jaseg/OpenStep/Outputs/BOM/Bill of Materials-cyberstairs.xls

Comment | Description | Designator | Footprint | LibRef | Quantity
Cap Pol1 | Polarized Capacitor (Radial) | C1 | RB7.6-15 | Cap Pol1 | 1.0
CAP 10nF 100V 0805(2012) | CAP 10nF 100V ±10% 0805 (2012 Metric) Thickness 1.45mm SMD | C2, C3, C4, C5, C6, C7, C8, C9, C10, C11, C12, C13, C14, C15, C16, C17 | CAPC0805(2012)145_L | CMP-1036-03853-1 | 16.0
SMAJ5.0CA-E3/5A | Transient Voltage Suppressor, 6.40 to 231 V, 5 V Stand-off Voltage, Bi-Directional, -55 to 155 degC, 2-pin DO-214AC, Pb-Free, Tape and Reel | D1 | VISH-DO-214AC-2_N | CMP-0548-00276-2 | 1.0
KP-1608MGC | LED, SMT, 0603(1608), 1.1mm thickness, Green | DS1 | KING-0603LED_GREEN_V | CMP-0404-00001-1 | 1.0
KP-1608SYCK | LED, SMT, 0603(1608), 1.1mm thickness, Yellow | DS2 | KING-0603LED_YELLOW_V | CMP-0404-00003-1 | 1.0
Header 4 | Header, 4-Pin | P1 | HDR1X4 | Header 4 | 1.0
Piezo solder pads | Header, 2-Pin | P2, P3, P4 | SMA_STANDING | Header 2 | 3.0
Phoenix_PT1,5/4-5,0H |  | P5 | Phoenix_PT_1,5/4-5,0-H | Phoenix_PT1,5/4-5,0H | 1.0
Header 3 | Header, 3-Pin | P6 | HDR1X3 | Header 3 | 1.0
IRLML6344TRPbF | N-channel Enhancement Mode Field-Effect Transistor; 5.8A/30V | Q1, Q2, Q3 | AO-SOT23-3_V | CMP-0278-00001-1 | 3.0
470K 1% 0805(2012) | 470K 0.125W 1% 0805 (2012 Metric) SMD | R1, R2, R3, R4, R5, R6, R7, R8, R9, R10, R12, R14, R16 | RESC0805(2012)_N | CMP-1013-00812-1 | 13.0
47K 1% 0805(2012) | 47K 0.125W 1% 0805 (2012 Metric) SMD | R11, R13, R15 | RESC0805(2012)_N | CMP-1013-00812-1 | 3.0
10K 1% 0805(2012) | 470K 0.125W 1% 0805 (2012 Metric) SMD | R17 | RESC0805(2012)_N | CMP-1013-00812-1 | 1.0
AP2202K-3.3TRG1 | 50 mA, 100 mA and 150 mA CMOS LDOs with Active-Low Shutdown and Reference Bypass, 5-Pin SOT-23, Extended Temperature, Tape and Reel | U1 | SOT-23-CT5_L | CMP-0136-00629-1 | 1.0
LM324M | Low Power Quad Operational Amplifier, 14-pin Narrow SOIC | U2 | M14A_M | CMP-0055-00738-2 | 1.0
MSP430G2153IPW20 | 16 MHz Mixed Signal Microcontroller with 1 KB Flash, 256 B SRAM and 24 GPIOs, -40 to 85 degC, 20-pin SOP (PW), Green (RoHS & no Sb/Br) | U3 | TI-PW20_N | CMP-0365-00610-1 | 1.0
ST1480ACDR | Multipoint RS-485/RS-422 Transceiver, 8-pin Narrow SOIC | U4 | M08A_N | CMP-0058-00814-1 | 1.0
7B-25.000MAAE-T | Crystal, SMD, 25.000000MHz Stab=50ppm 18.0pF | Y1 | ABRA-ABM3B-4_V | CMP-0277-00001-1 | 1.0
