jaseg/OpenStep/cyberstairs.PDF

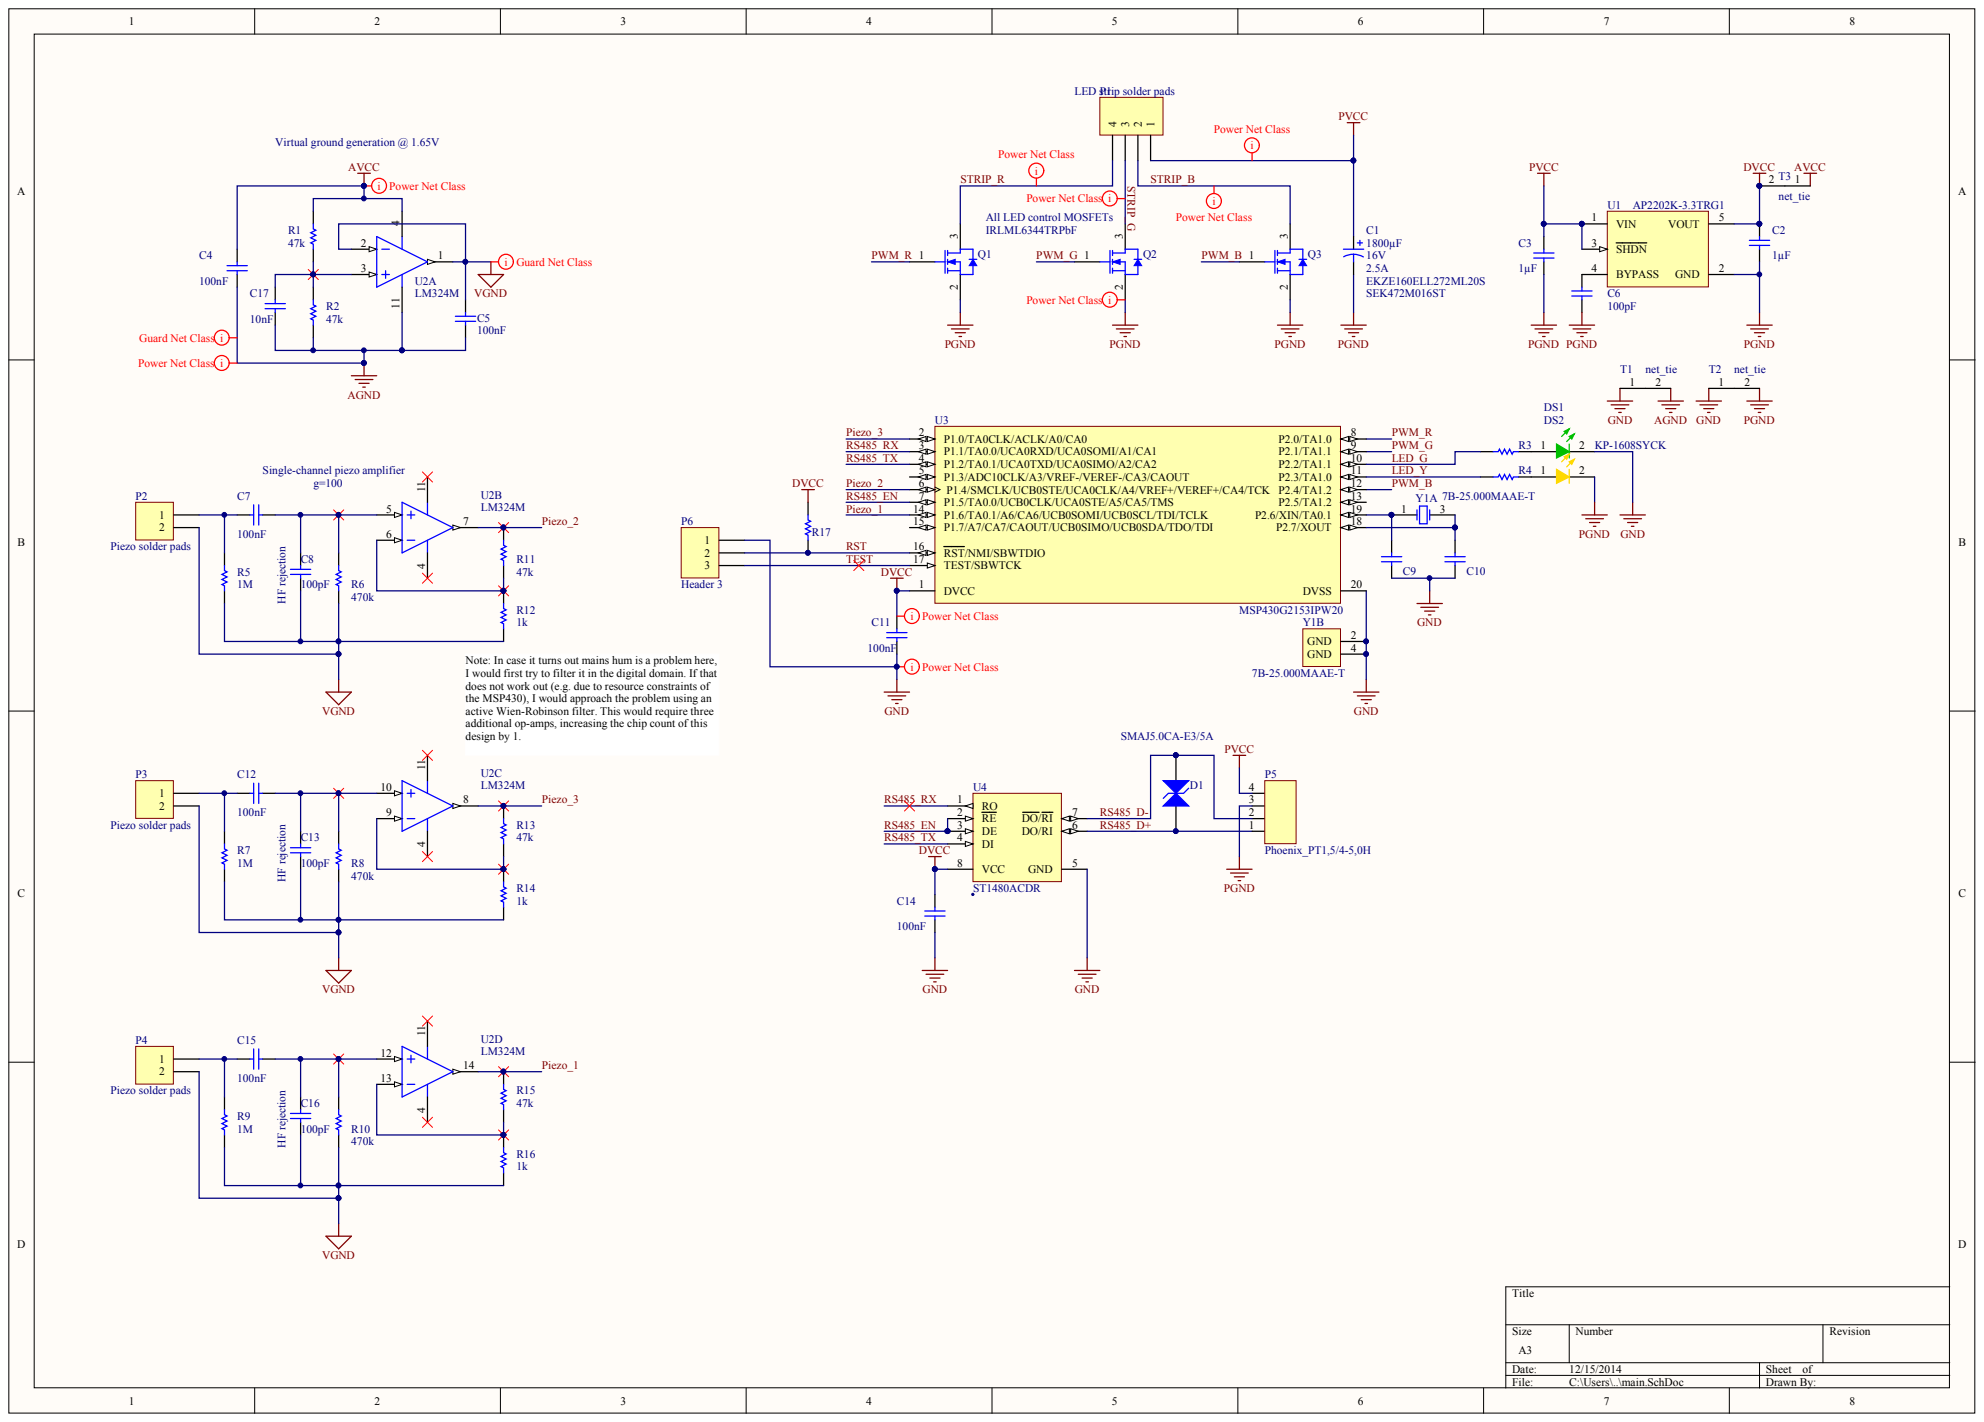
[picture p1: page 1]

LED strip solder pads

All LED control MOSFETs
IRLML6344TRPbF

Single-channel piezo amplifier

RST 1

TEST | | TEST/SBWTCK 17
DVCC C11 100nF | | DVCC 1

Note: In case it turns out mains hum is a problem here,
I would first try to filter it in the digital domain. If that
does not work out (e.g. due to resource constraints of
the MSP430), I would approach the problem using an
active Wien-Robinson filter. This would require three
additional op-amps, increasing the chip count of this
design by 1.

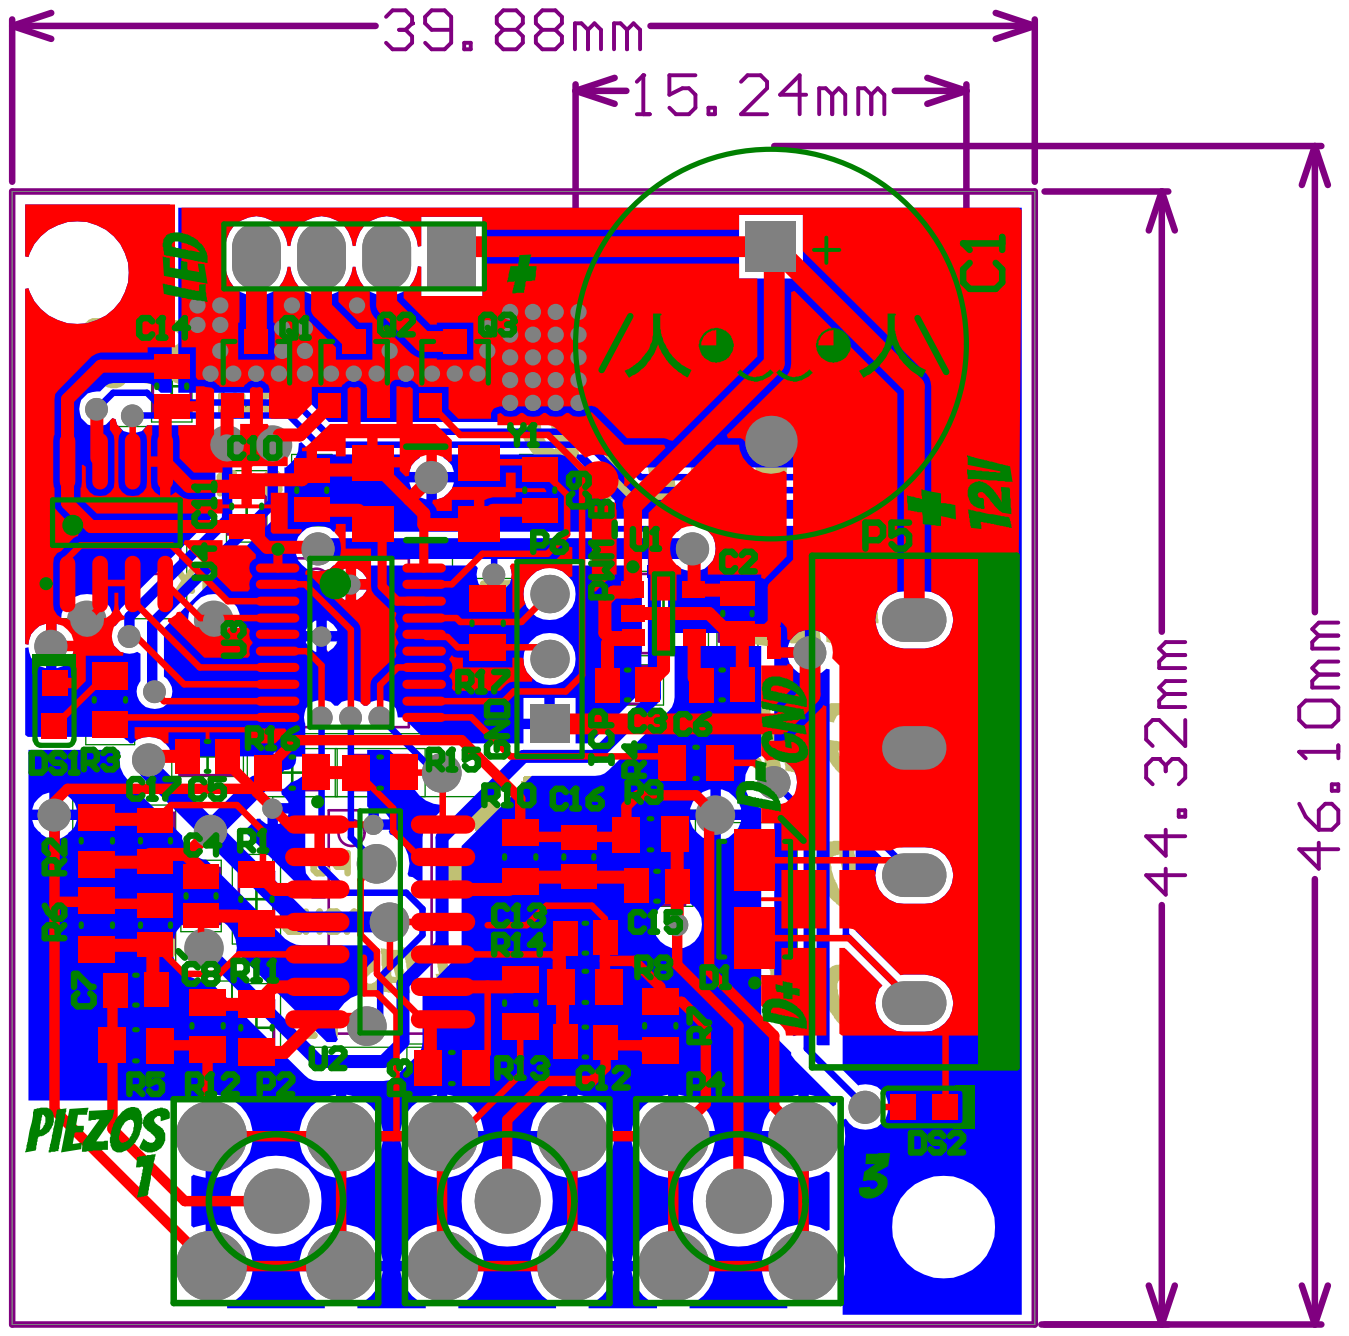
[picture p2: page 2]

# Difference Report For Project cyberstairs.PrjPcb and main.PcbDoc

No differences were detected.

Monday 15-Dec-15/2014 4:06:38 PM | Page 1 of 1
