jaseg/OpenStep/(list of files, drawings)

Other design files:
cyberstairs.PrjPcb
cyberstairs.SCHLIB
main.PcbDoc
main.PcbLib
main.SchDoc
RJ-45.PcbLib
SMA.PcbLib
