jaseg/OpenStep/(commit log)

2014-07-03 Initial import of altium files
    [cyberstairs.PrjPcb, main.SchDoc]
2014-07-03 Preliminary input amp circuitry finished.
    [main.SchDoc]
2014-07-05 Routing almost completed
    [RJ-45.PcbLib, cyberstairs.PrjPcb, cyberstairs.SCHLIB, main.PcbDoc, main.PcbLib, main.SchDoc]
2014-07-07 First preliminary layout complete
    [cyberstairs.SCHLIB, main.PcbDoc, main.PcbLib, main.SchDoc]
2014-07-07 First layout draft
    [cyberstairs.PrjPcb, main.PcbDoc, main.SchDoc]
2014-07-07 Minor analog ground routing fixes
    [main.PcbDoc]
2014-07-08 Small layout improvements and gerber export
    [main.PcbDoc, main.PcbLib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]
2014-07-08 Fixed the silk screen
    [cyberstairs.PrjPcb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]
2014-07-08 Small layout fixes
    [main.GBL, main.GBO, main.GBP, main.GBS, main.GTL, main.GTO, main.GTP, main.GTS]
2014-08-26 Did some preliminary gerber exports
2014-09-03 Fixed gerbers for outline layer
    [main.GBL, main.GBO, main.GBP, main.GBS, main.GTL, main.GTO, main.GTP, main.GTS]
2014-09-29 Added a bunch of thermal vias for the MOSFETs
    ...and made a Gerber export.
    [cyberstairs.PrjPcb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]
2014-10-30 Fixed a couple of errors from the first prototype
    [cyberstairs.PrjPcb, main.PcbLib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]
2014-12-03 Added test points
    [main.PcbLib, main.SchDoc]
2014-12-04 Changed coax connectors to SMA
    [Bill of Materials-cyberstairs.xls, SMA.PcbLib, cyberstairs.PrjPcb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]
2014-12-05 Small layout fixes for v1.0
    [SMA.PcbLib, cyberstairs.PrjPcb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]
2014-12-09 SMA footprint holes made larger, clearance increased
    Increased overall clearance from 6mil to 10mil
    [Bill of Materials-cyberstairs.xls, SMA.PcbLib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]
2014-12-12 Re-organized folders to remove spaces for make
    [Bill of Materials-cyberstairs.xls, cyberstairs.PrjPcb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]
2014-12-12 Packaged the gerbers to a handy zip
2014-12-12 Added paste layers
    [main.GBP, main.GTP]
2014-12-13 Added a pullup on the µC's RST pin
    [Bill of Materials-cyberstairs.xls, cyberstairs.PrjPcb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]
2014-12-13 Fixed up the LED strip footprint
    [cyberstairs.PrjPcb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]
2014-12-13 Fixed paste masks
    [main.GBL, main.GBO, main.GBP, main.GBS, main.GKO, main.GTL, main.GTO, main.GTP]
2014-12-15 Increased solder mask expansion for the µC
    [Bill of Materials-cyberstairs.xls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]
2015-02-06 Final schematic version. Increased front-end impedance.
    [main.SchDoc]
2015-02-14 Worked out some more little errors
    [main.c]
2015-02-18 re-enabled adc
2015-02-18 fixed broadcast data acquisition
    [protocol.c, serial_mux.py, uart-util.h]
2015-02-19 basic pwm stuff working
2015-02-21 PWM test case
2015-02-22 Fixed the reset issue and debugged the PWM one
    [main.c, protocol.c, test.py]
2015-02-22 Fixed comms issues with additional framing
    [main.c, protocol.c, serial_mux.py, test.py, uart-util.h]
2015-03-01 WOrking on frame ignore logic
2015-03-04 basic comm working, stability problems with multicast comm
    [protocol.c, serial_mux.py, test.py]
2015-03-14 Working on better ADC interrupt handling, paving the way for the PWM hack
